HapeMask/rpi_experiments/resources/trig_none.png

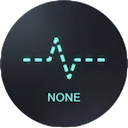
resources/trig_none.png
