HapeMask/rpi_experiments/resources/pressed_orig/trig_oneshot_pressed.png

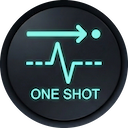
resources/pressed_orig/trig_oneshot_pressed.png
