HapeMask/rpi_experiments/resources/pan.png

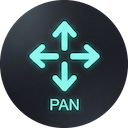
resources/pan.png
