HapeMask/rpi_experiments/resources/pan_pressed.png

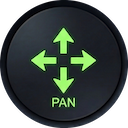
resources/pan_pressed.png
