HapeMask/rpi_experiments/resources/pause.png

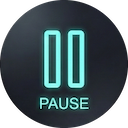
resources/pause.png
