HapeMask/rpi_experiments/resources/pause_pressed.png

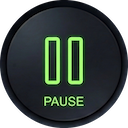
resources/pause_pressed.png
