HapeMask/rpi_experiments/resources/pressed_orig/pause_pressed.png

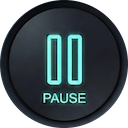
resources/pressed_orig/pause_pressed.png
