HapeMask/rpi_experiments/resources/pressed_orig/reset_zoom_pressed.png

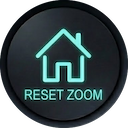
resources/pressed_orig/reset_zoom_pressed.png
