HapeMask/rpi_experiments/resources/pressed_orig/trig_auto_pressed.png

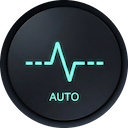
resources/pressed_orig/trig_auto_pressed.png
