HapeMask/rpi_experiments/resources/pressed_orig/trig_falling_pressed.png

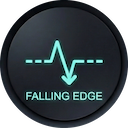
resources/pressed_orig/trig_falling_pressed.png
