HapeMask/rpi_experiments/resources/pressed_orig/trig_rising_pressed.png

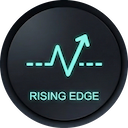
resources/pressed_orig/trig_rising_pressed.png
