HapeMask/rpi_experiments/resources/pressed_orig/zoom_pressed.png

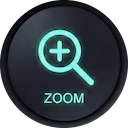
resources/pressed_orig/zoom_pressed.png
