HapeMask/rpi_experiments/resources/reset_zoom.png

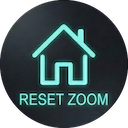
resources/reset_zoom.png
