HapeMask/rpi_experiments/resources/reset_zoom_pressed.png

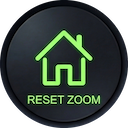
resources/reset_zoom_pressed.png
