HapeMask/rpi_experiments/resources/trig_falling.png

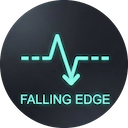
resources/trig_falling.png
