HapeMask/rpi_experiments/resources/trig_falling_pressed.png

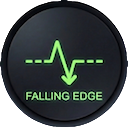
resources/trig_falling_pressed.png
