HapeMask/rpi_experiments/resources/trig_none_pressed.png

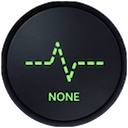
resources/trig_none_pressed.png
