HapeMask/rpi_experiments/resources/trig_oneshot.png

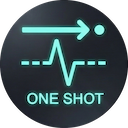
resources/trig_oneshot.png
