HapeMask/rpi_experiments/resources/trig_oneshot_pressed.png

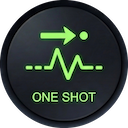
resources/trig_oneshot_pressed.png
