HapeMask/rpi_experiments/resources/trig_rising.png

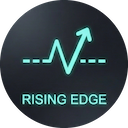
resources/trig_rising.png
