HapeMask/rpi_experiments/resources/trig_rising_pressed.png

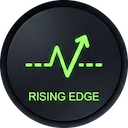
resources/trig_rising_pressed.png
