HapeMask/rpi_experiments/resources/zoom.png

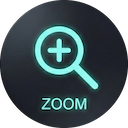
resources/zoom.png
