HapeMask/rpi_experiments/resources/zoom_pressed.png

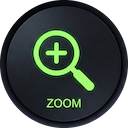
resources/zoom_pressed.png
