HapeMask/rpi_experiments/schematics/rpi_oscilloscope/2-Channel RPi Oscilloscope.kicad_pcb

## KiCad design schematics/rpi_oscilloscope/2-Channel RPi Oscilloscope.kicad_pcb (2026-06-03)

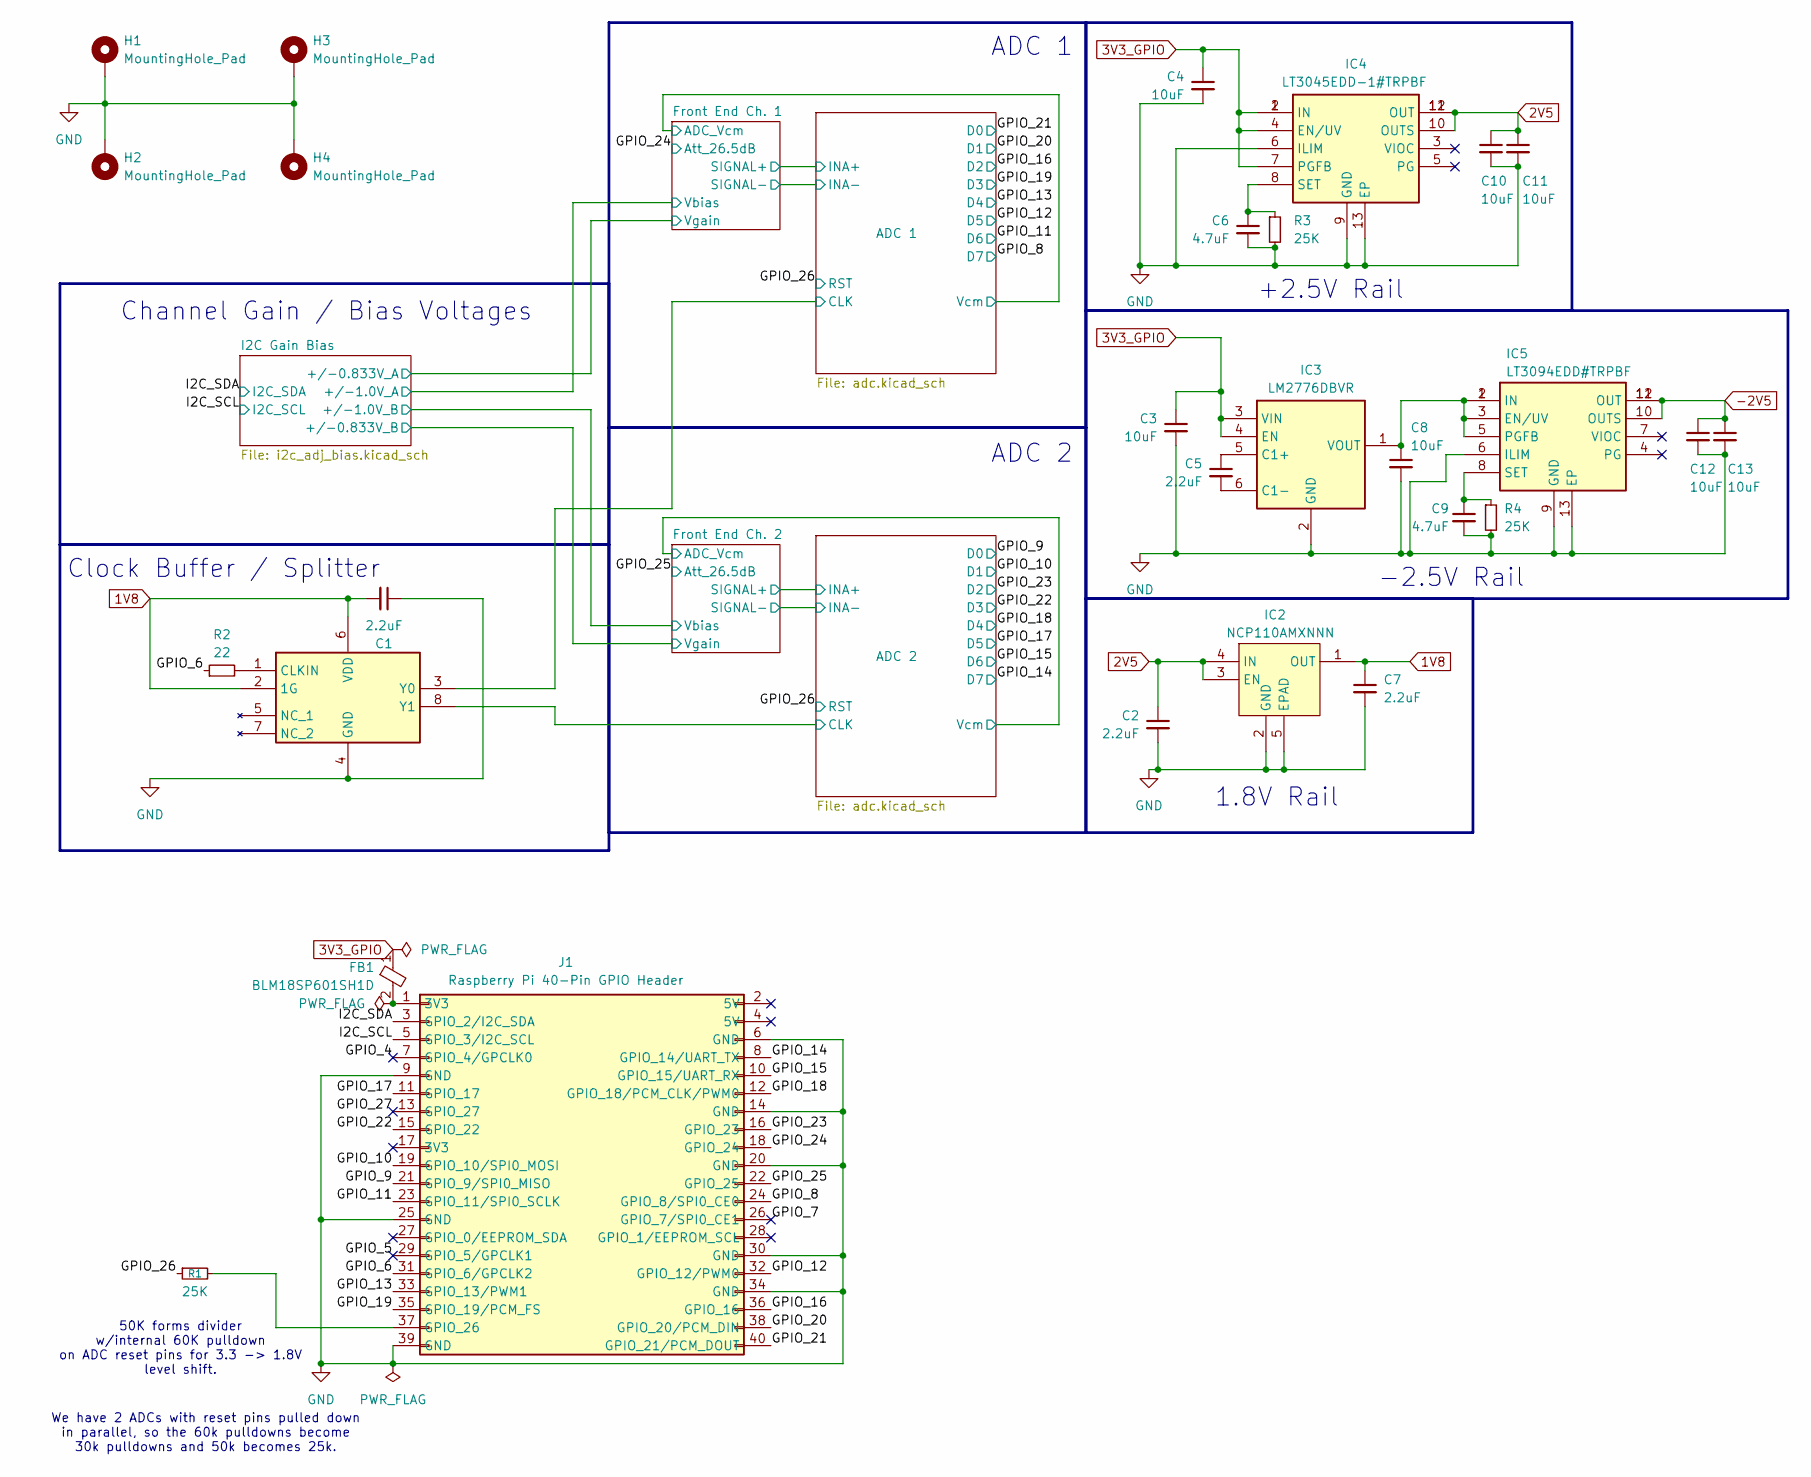
[picture p24: schematic 2-Channel RPi Oscilloscope.kicad_sch]

Parts:
C1, C2, C5, C7: 2.2uF; C_0805_2012Metric
C3, C4, C8, C10, C11, C12, C13: 10uF; C_0805_2012Metric; Manufacturer_Part_Number CL21B106KOQNNNE
C6, C9: 4.7uF; C_0805_2012Metric; Manufacturer_Part_Number GRM21BR71C475ME51K
FB1: BLM18SP601SH1D; BLM18SP221SN1B; Manufacturer_Part_Number BLM18SP601SH1D; Mouser Part Number 81-BLM18SP601SH1D
H1, H2, H3, H4: MountingHole_Pad; MountingHole_3mm_Pad_TopBottom
IC1: LMK1C1102PWR; SOP65P640X120-8N; Manufacturer_Part_Number LMK1C1102PWR; Mouser Part Number 595-LMK1C1102PWR
IC2: NCP110AMXNNN; OnSemi_XDFN4-1EP_1.0x1.0mm_EP0.52x0.52mm; Manufacturer_Part_Number NCP110AMX180TBG
IC3: LM2776DBVR; SOT95P280X145-6N; Manufacturer_Part_Number LM2776DBVR; Mouser Part Number 595-LM2776DBVR
IC4: LT3045EDD-1#TRPBF; SON45P300X300X80-13N-D; Manufacturer_Part_Number LT3045EDD-1#TRPBF; Mouser Part Number 584-LT3045EDD-1TRPBF
IC5: LT3094EDD#TRPBF; SON45P300X300X80-13N-D; Manufacturer_Part_Number LT3094EDD#TRPBF; Mouser Part Number 584-LT3094EDD#TRPBF
J1: Raspberry Pi 40-Pin GPIO Header; PinSocket_2x20_P2.54mm_Vertical
R1: 25K; R_0805_2012Metric
R2: 22; R_0805_2012Metric; Manufacturer_Part_Number RS73G2ATTD22R0B
R3, R4: 25K; R_0805_2012Metric; Manufacturer_Part_Number CPF-A-0805B25KE

Connections:
1V8: C1.2, C7.1, IC1.2 (1G), IC1.6 (VDD), IC2.1 (OUT); also elsewhere on the board
2V5: C2.1, C10.1, C11.1, IC2.3 (EN), IC2.4 (IN), IC4.10 (OUTS), IC4.11 (OUT), IC4.12 (OUT); also elsewhere on the board
3V3_GPIO: C3.1, C4.1, FB1.1, IC3.3 (VIN), IC3.4 (EN), IC4.1 (IN), IC4.2 (IN), IC4.4 (EN/UV), IC4.7 (PGFB); also elsewhere on the board
-2V5: C12.1, C13.1, IC5.10 (OUTS), IC5.11 (OUT), IC5.12 (OUT); also elsewhere on the board
/ADC 1/CLK: IC1.3 (Y0); also elsewhere on the board
/ADC 2/CLK: IC1.8 (Y1); also elsewhere on the board
/GPIO_4: J1.7 (GPIO_4/GPCLK0)
/GPIO_5: J1.29 (GPIO_5/GPCLK1)
/GPIO_6: J1.31 (GPIO_6/GPCLK2), R2.1
/GPIO_7: J1.26 (GPIO_7/SPI0_CE1)
/GPIO_8: J1.24 (GPIO_8/SPI0_CE0); also elsewhere on the board
/GPIO_9: J1.21 (GPIO_9/SPI0_MISO); also elsewhere on the board
/GPIO_10: J1.19 (GPIO_10/SPI0_MOSI); also elsewhere on the board
/GPIO_11: J1.23 (GPIO_11/SPI0_SCLK); also elsewhere on the board
/GPIO_12: J1.32 (GPIO_12/PWM0); also elsewhere on the board
/GPIO_13: J1.33 (GPIO_13/PWM1); also elsewhere on the board
/GPIO_14: J1.8 (GPIO_14/UART_TX); also elsewhere on the board
/GPIO_15: J1.10 (GPIO_15/UART_RX); also elsewhere on the board
/GPIO_16: J1.36 (GPIO_16); also elsewhere on the board
/GPIO_17: J1.11 (GPIO_17); also elsewhere on the board
/GPIO_18: J1.12 (GPIO_18/PCM_CLK/PWM0); also elsewhere on the board
/GPIO_19: J1.35 (GPIO_19/PCM_FS); also elsewhere on the board
/GPIO_20: J1.38 (GPIO_20/PCM_DIN); also elsewhere on the board
/GPIO_21: J1.40 (GPIO_21/PCM_DOUT); also elsewhere on the board
/GPIO_22: J1.15 (GPIO_22); also elsewhere on the board
/GPIO_23: J1.16 (GPIO_23); also elsewhere on the board
/GPIO_24: J1.18 (GPIO_24); also elsewhere on the board
/GPIO_25: J1.22 (GPIO_25); also elsewhere on the board
/GPIO_26: R1.1; also elsewhere on the board
/GPIO_27: J1.13 (GPIO_27)
/I2C_SCL: J1.5 (GPIO_3/I2C_SCL); also elsewhere on the board
/I2C_SDA: J1.3 (GPIO_2/I2C_SDA); also elsewhere on the board
GND: C1.1, C2.2, C3.2, C4.2, C6.2, C7.2, C8.2, C9.2, C10.2, C11.2, C12.2, C13.2, H1.1, H2.1, H3.1, H4.1, IC1.4 (GND), IC2.2 (GND), IC2.5 (EPAD), IC3.2 (GND), IC4.6 (ILIM), IC4.9 (GND), IC4.13 (EP), IC5.6 (ILIM), IC5.9 (GND), IC5.13 (EP), J1.6 (GND), J1.9 (GND), J1.14 (GND), J1.20 (GND), J1.25 (GND), J1.30 (GND), J1.34 (GND), J1.39 (GND), R3.2, R4.2; also elsewhere on the board
unnamed: FB1.2, J1.1 (3V3)
unnamed: IC1.1 (CLKIN), R2.2
unnamed: C5.1, IC3.5 (C1+)
unnamed: C5.2, IC3.6 (C1-)
unnamed: C8.1, IC3.1 (VOUT), IC5.1 (IN), IC5.2 (IN), IC5.3 (EN/UV), IC5.5 (PGFB)
unnamed: C6.1, IC4.8 (SET), R3.1
unnamed: C9.1, IC5.8 (SET), R4.1
unnamed: J1.37 (GPIO_26), R1.2

Notes on the sheet:
ADC 1
ADC 2
We have 2 ADCs with reset pins pulled down in parallel, so the 60k pulldowns become 30k pulldowns and 50k becomes 25k.
+2.5V Rail
-2.5V Rail
1.8V Rail
50K forms divider w/internal 60K pulldown on ADC reset pins for 3.3 -> 1.8V level shift.
Clock Buffer / Splitter
Channel Gain / Bias Voltages

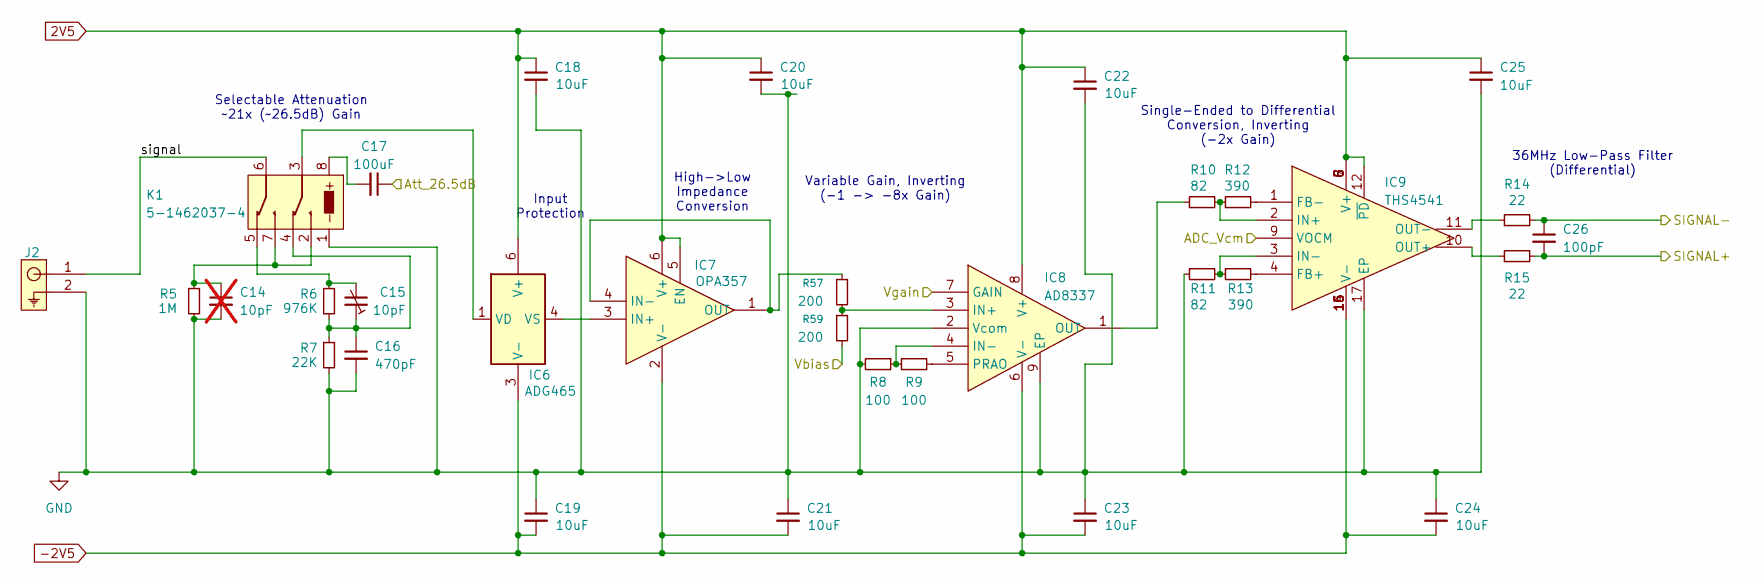
[picture p25: schematic frontend.kicad_sch]

Parts:
C14: 10pF; C_0805_2012Metric; not fitted
C15: 10pF; C_Trimmer_Sprague-Goodman_SGC3; Manufacturer_Part_Number SGC3S300
C16: 470pF; C_0805_2012Metric; Manufacturer_Part_Number GRM2165C1H201JA01D
C17: 100uF; C_1206_3216Metric; Manufacturer_Part_Number GRM31CR61A107MEA8L
C18, C19, C20, C21, C22, C23, C24, C25: 10uF; C_0805_2012Metric; Manufacturer_Part_Number CL21B106KOQNNNE
C26: 100pF; C_0805_2012Metric
IC6: ADG465; SOT95P280X145-6N; Manufacturer_Part_Number ADG465BRTZ-REEL7
IC7: OPA357; SOT95P280X145-6N; Manufacturer_Part_Number OPA357AIDBVR; Mouser Part Number 595-OPA357AIDBVR
IC8: AD8337; SON50P300X300X85-9N-D; Manufacturer_Part_Number AD8337BCPZ-REEL7; Mouser Part Number 584-AD8337BCPZ-R7
IC9: THS4541; QFN50P300X300X100-17N-D; Manufacturer_Part_Number THS4541IRGTR; Mouser Part Number 595-THS4541IRGTR
J2: 5-pin Coaxial Connector; 031_5431_10RFX; Manufacturer_Part_Number 031-5431-10RFX
K1: 5-1462037-4; 514620374; Manufacturer_Part_Number 5-1462037-4; Mouser Part Number 655-5-1462037-4
R5: 1M; R_0805_2012Metric
R6: 976K; R_0805_2012Metric
R7: 22K; R_0805_2012Metric
R8, R9: 100; R_0805_2012Metric
R10, R11: 82; R_0805_2012Metric
R12, R13: 390; R_0805_2012Metric
R14, R15: 22; R_0805_2012Metric; Manufacturer_Part_Number RS73G2ATTD22R0B
R57, R59: 200; R_0805_2012Metric

Connections:
2V5: C18.1, C20.1, C22.1, C25.1, IC6.6 (V+), IC7.5 (EN), IC7.6 (V+), IC8.8 (V+), IC9.5 (V+), IC9.6 (V+), IC9.7 (V+), IC9.8 (V+), IC9.12 (~PD); also elsewhere on the board
-2V5: C19.2, C21.2, C23.2, C24.2, IC6.3 (V-), IC7.2 (V-), IC8.6 (V-), IC9.13 (V-), IC9.14 (V-), IC9.15 (V-), IC9.16 (V-); also elsewhere on the board
/ADC 1/INA+: C26.2, R15.2; also elsewhere on the board
/ADC 1/INA-: C26.1, R14.2; also elsewhere on the board
/ADC 1/Vcm: IC9.9 (VOCM); also elsewhere on the board
/Front End Ch. 1/Vbias: R59.2; also elsewhere on the board
/Front End Ch. 1/Vgain: IC8.7 (GAIN); also elsewhere on the board
/Front End Ch. 1/signal: J2.1, K1.6
/GPIO_24: C17.1; also elsewhere on the board
GND: C14.2, C16.2, C18.2, C19.1, C20.2, C21.1, C22.2, C23.1, C24.1, C25.2, IC8.2 (Vcom), IC8.9 (EP), IC9.17 (EP), J2.2, K1.1, R5.2, R7.2, R8.2, R11.1; also elsewhere on the board
unnamed: C14.1, K1.2, K1.7, R5.1
unnamed: C15.1, C16.1, K1.4, R6.2, R7.1
unnamed: C15.2, K1.5, R6.1
unnamed: C17.2, K1.8
unnamed: IC6.1 (VD), K1.3
unnamed: IC6.4 (VS), IC7.3 (IN+)
unnamed: IC7.1 (OUT), IC7.4 (IN-), R57.1
unnamed: IC8.3 (IN+), R57.2, R59.1
unnamed: IC8.4 (IN-), R8.1, R9.1
unnamed: IC8.1 (OUT), R10.1
unnamed: IC8.5 (PRAO), R9.2
unnamed: IC9.4 (FB+), R13.2
unnamed: IC9.1 (FB-), R12.2
unnamed: IC9.2 (IN+), R10.2, R12.1
unnamed: IC9.3 (IN-), R11.2, R13.1
unnamed: IC9.10 (OUT+), R15.1
unnamed: IC9.11 (OUT-), R14.1

Parts of its further copies:
C27: 10pF; C_0805_2012Metric; not fitted
C28: 10pF; C_Trimmer_Sprague-Goodman_SGC3; Manufacturer_Part_Number SGC3S300
C29: 470pF; C_0805_2012Metric; Manufacturer_Part_Number GRM2165C1H201JA01D
C30: 100uF; C_1206_3216Metric; Manufacturer_Part_Number GRM31CR61A107MEA8L
C31, C32, C33, C34, C35, C36, C37, C38: 10uF; C_0805_2012Metric; Manufacturer_Part_Number CL21B106KOQNNNE
C39: 100pF; C_0805_2012Metric
IC10: ADG465; SOT95P280X145-6N; Manufacturer_Part_Number ADG465BRTZ-REEL7
IC11: OPA357; SOT95P280X145-6N; Manufacturer_Part_Number OPA357AIDBVR; Mouser Part Number 595-OPA357AIDBVR
IC12: AD8337; SON50P300X300X85-9N-D; Manufacturer_Part_Number AD8337BCPZ-REEL7; Mouser Part Number 584-AD8337BCPZ-R7
IC13: THS4541; QFN50P300X300X100-17N-D; Manufacturer_Part_Number THS4541IRGTR; Mouser Part Number 595-THS4541IRGTR
J3: 5-pin Coaxial Connector; 031_5431_10RFX; Manufacturer_Part_Number 031-5431-10RFX
K2: 5-1462037-4; 514620374; Manufacturer_Part_Number 5-1462037-4; Mouser Part Number 655-5-1462037-4
R16: 1M; R_0805_2012Metric
R17: 976K; R_0805_2012Metric
R18: 22K; R_0805_2012Metric
R19, R20: 100; R_0805_2012Metric
R21, R22: 82; R_0805_2012Metric
R23, R24: 390; R_0805_2012Metric
R25, R26: 22; R_0805_2012Metric; Manufacturer_Part_Number RS73G2ATTD22R0B
R58, R60: 200; R_0805_2012Metric

Connections of its further copies:
2V5: C31.1, C33.1, C35.1, C38.1, IC10.6 (V+), IC11.5 (EN), IC11.6 (V+), IC12.8 (V+), IC13.5 (V+), IC13.6 (V+), IC13.7 (V+), IC13.8 (V+), IC13.12 (~PD); also elsewhere on the board
-2V5: C32.2, C34.2, C36.2, C37.2, IC10.3 (V-), IC11.2 (V-), IC12.6 (V-), IC13.13 (V-), IC13.14 (V-), IC13.15 (V-), IC13.16 (V-); also elsewhere on the board
/ADC 2/INA+: C39.2, R26.2; also elsewhere on the board
/ADC 2/INA-: C39.1, R25.2; also elsewhere on the board
/ADC 2/Vcm: IC13.9 (VOCM); also elsewhere on the board
/Front End Ch. 2/Vbias: R60.2; also elsewhere on the board
/Front End Ch. 2/Vgain: IC12.7 (GAIN); also elsewhere on the board
/Front End Ch. 2/signal: J3.1, K2.6
/GPIO_25: C30.1; also elsewhere on the board
GND: C27.2, C29.2, C31.2, C32.1, C33.2, C34.1, C35.2, C36.1, C37.1, C38.2, IC12.2 (Vcom), IC12.9 (EP), IC13.17 (EP), J3.2, K2.1, R16.2, R18.2, R19.2, R22.1; also elsewhere on the board
unnamed: C27.1, K2.2, K2.7, R16.1
unnamed: C28.1, C29.1, K2.4, R17.2, R18.1
unnamed: C28.2, K2.5, R17.1
unnamed: C30.2, K2.8
unnamed: IC10.1 (VD), K2.3
unnamed: IC10.4 (VS), IC11.3 (IN+)
unnamed: IC11.1 (OUT), IC11.4 (IN-), R58.1
unnamed: IC12.3 (IN+), R58.2, R60.1
unnamed: IC12.4 (IN-), R19.1, R20.1
unnamed: IC12.1 (OUT), R21.1
unnamed: IC12.5 (PRAO), R20.2
unnamed: IC13.4 (FB+), R24.2
unnamed: IC13.1 (FB-), R23.2
unnamed: IC13.2 (IN+), R21.2, R23.1
unnamed: IC13.3 (IN-), R22.2, R24.1
unnamed: IC13.10 (OUT+), R26.1
unnamed: IC13.11 (OUT-), R25.1

Notes on the sheet:
Input Protection
Single-Ended to Differential Conversion, Inverting (-2x Gain)
High->Low Impedance Conversion
36MHz Low-Pass Filter (Differential)
Selectable Attenuation ~21x (~26.5dB) Gain
Variable Gain, Inverting (-1 -> -8x Gain)

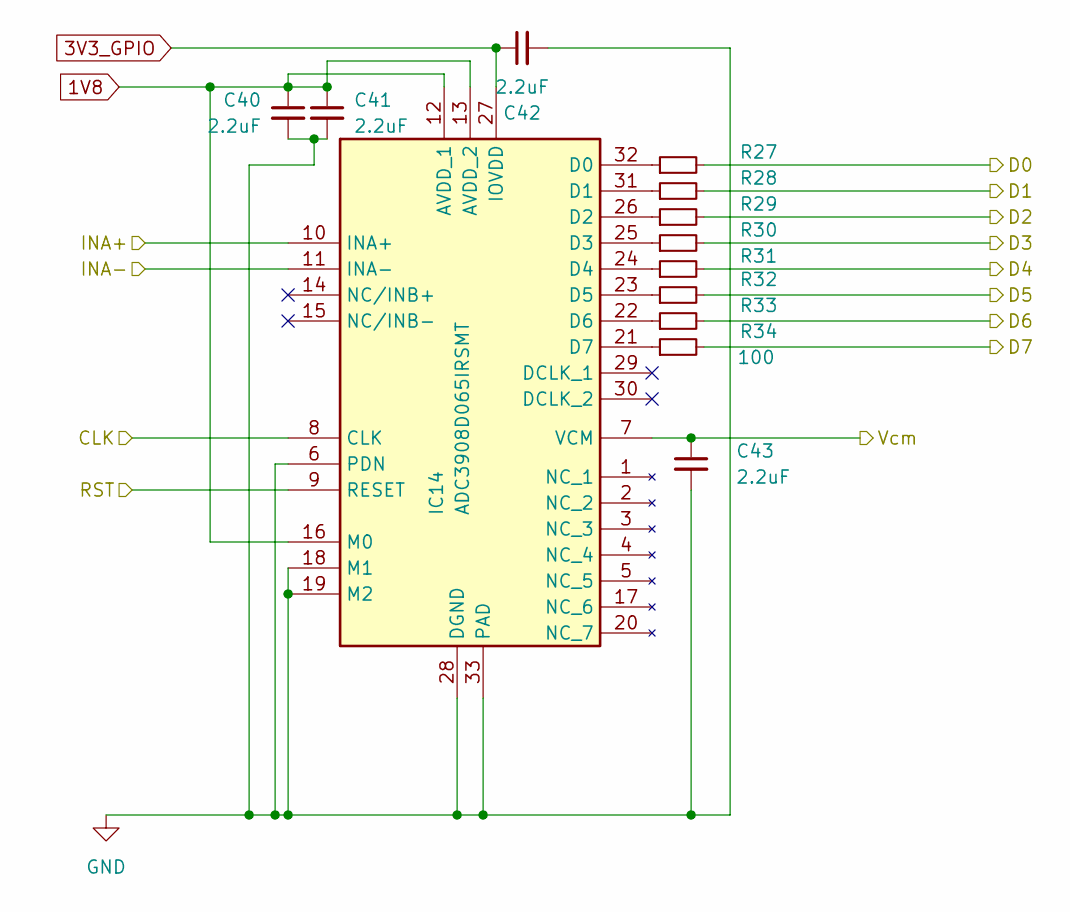
[picture p26: schematic adc.kicad_sch]

Parts:
C40, C41, C42, C43: 2.2uF; C_0805_2012Metric
IC14: ADC3908D065IRSMT; QFN40P400X400X100-33N-D; Manufacturer_Part_Number ADC3908D065IRSMT
R27, R28, R29, R30, R31, R32, R33, R34: 100; R_0805_2012Metric; Manufacturer_Part_Number RS73G2ATTD22R0B

Connections:
1V8: C40.1, C41.1, IC14.12 (AVDD_1), IC14.13 (AVDD_2), IC14.16 (M0); also elsewhere on the board
3V3_GPIO: C42.1, IC14.27 (IOVDD); also elsewhere on the board
/ADC 1/CLK: IC14.8 (CLK); also elsewhere on the board
/ADC 1/INA+: IC14.10 (INA+); also elsewhere on the board
/ADC 1/INA-: IC14.11 (INA-); also elsewhere on the board
/ADC 1/Vcm: C43.1, IC14.7 (VCM); also elsewhere on the board
/GPIO_8: R34.2; also elsewhere on the board
/GPIO_11: R33.2; also elsewhere on the board
/GPIO_12: R32.2; also elsewhere on the board
/GPIO_13: R31.2; also elsewhere on the board
/GPIO_16: R29.2; also elsewhere on the board
/GPIO_19: R30.2; also elsewhere on the board
/GPIO_20: R28.2; also elsewhere on the board
/GPIO_21: R27.2; also elsewhere on the board
/GPIO_26: IC14.9 (RESET); also elsewhere on the board
GND: C40.2, C41.2, C42.2, C43.2, IC14.6 (PDN), IC14.18 (M1), IC14.19 (M2), IC14.28 (DGND), IC14.33 (PAD); also elsewhere on the board
unnamed: IC14.32 (D0), R27.1
unnamed: IC14.31 (D1), R28.1
unnamed: IC14.26 (D2), R29.1
unnamed: IC14.25 (D3), R30.1
unnamed: IC14.24 (D4), R31.1
unnamed: IC14.23 (D5), R32.1
unnamed: IC14.22 (D6), R33.1
unnamed: IC14.21 (D7), R34.1

Parts of its further copies:
C44, C45, C46, C47: 2.2uF; C_0805_2012Metric
IC15: ADC3908D065IRSMT; QFN40P400X400X100-33N-D; Manufacturer_Part_Number ADC3908D065IRSMT
R35, R36, R37, R38, R39, R40, R41, R42: 100; R_0805_2012Metric; Manufacturer_Part_Number RS73G2ATTD22R0B

Connections of its further copies:
1V8: C44.1, C45.1, IC15.12 (AVDD_1), IC15.13 (AVDD_2), IC15.16 (M0); also elsewhere on the board
3V3_GPIO: C46.1, IC15.27 (IOVDD); also elsewhere on the board
/ADC 2/CLK: IC15.8 (CLK); also elsewhere on the board
/ADC 2/INA+: IC15.10 (INA+); also elsewhere on the board
/ADC 2/INA-: IC15.11 (INA-); also elsewhere on the board
/ADC 2/Vcm: C47.1, IC15.7 (VCM); also elsewhere on the board
/GPIO_9: R35.2; also elsewhere on the board
/GPIO_10: R36.2; also elsewhere on the board
/GPIO_14: R42.2; also elsewhere on the board
/GPIO_15: R41.2; also elsewhere on the board
/GPIO_17: R40.2; also elsewhere on the board
/GPIO_18: R39.2; also elsewhere on the board
/GPIO_22: R38.2; also elsewhere on the board
/GPIO_23: R37.2; also elsewhere on the board
/GPIO_26: IC15.9 (RESET); also elsewhere on the board
GND: C44.2, C45.2, C46.2, C47.2, IC15.6 (PDN), IC15.18 (M1), IC15.19 (M2), IC15.28 (DGND), IC15.33 (PAD); also elsewhere on the board
unnamed: IC15.32 (D0), R35.1
unnamed: IC15.31 (D1), R36.1
unnamed: IC15.26 (D2), R37.1
unnamed: IC15.25 (D3), R38.1
unnamed: IC15.24 (D4), R39.1
unnamed: IC15.23 (D5), R40.1
unnamed: IC15.22 (D6), R41.1
unnamed: IC15.21 (D7), R42.1

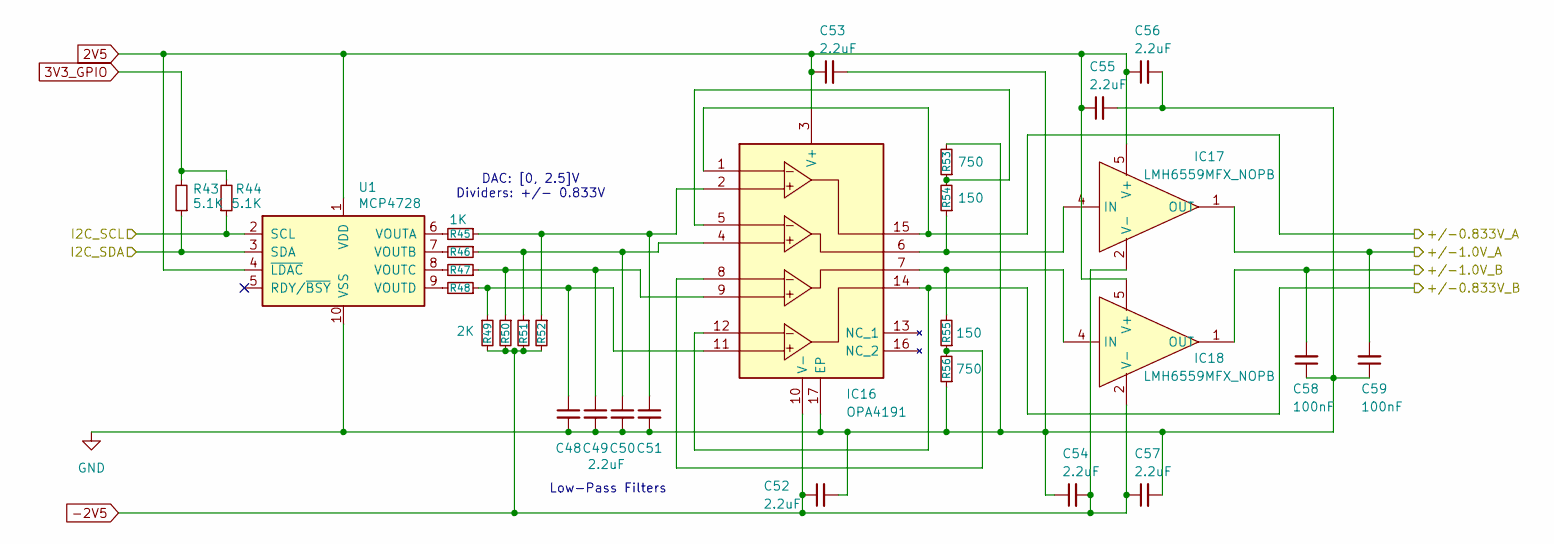
[picture p27: schematic i2c_adj_bias.kicad_sch]

Parts:
C48, C49, C50, C51, C52, C53, C54, C55, C56, C57: 2.2uF; C_0805_2012Metric
C58, C59: 100nF; C_0805_2012Metric
IC16: OPA4191; QFN65P400X400X80-17N-D; Manufacturer_Part_Number OPA4191IRUMR; Mouser Part Number 595-OPA4191IRUMR
IC17, IC18: LMH6559MFX_NOPB; SOT95P280X145-5N; Manufacturer_Part_Number LMH6559MFX/NOPB; Mouser Part Number 926-LMH6559MFX/NOPB
R43, R44: 5.1K; R_0805_2012Metric
R45, R46, R47, R48: 1K; R_0805_2012Metric
R49, R50, R51, R52: 2K; R_0805_2012Metric
R53, R56: 750; R_0805_2012Metric
R54, R55: 150; R_0805_2012Metric
U1: MCP4728; MSOP-10_3x3mm_P0.5mm; Manufacturer_Part_Number MCP4728T-E/UN

Connections:
2V5: C53.1, C55.1, C56.1, IC16.3 (V+), IC17.5 (V+), IC18.5 (V+), U1.1 (VDD), U1.4 (~LDAC); also elsewhere on the board
3V3_GPIO: R43.2, R44.2; also elsewhere on the board
-2V5: C52.1, C54.2, C57.1, IC16.10 (V-), IC17.2 (V-), IC18.2 (V-), R49.2, R50.2, R51.2, R52.2; also elsewhere on the board
/Front End Ch. 1/Vbias: C59.2, IC17.1 (OUT); also elsewhere on the board
/Front End Ch. 1/Vgain: IC16.1, IC16.15; also elsewhere on the board
/Front End Ch. 2/Vbias: C58.2, IC18.1 (OUT); also elsewhere on the board
/Front End Ch. 2/Vgain: IC16.12, IC16.14; also elsewhere on the board
/I2C_SCL: R44.1, U1.2 (SCL); also elsewhere on the board
/I2C_SDA: R43.1, U1.3 (SDA); also elsewhere on the board
GND: C48.2, C49.2, C50.2, C51.2, C52.2, C53.2, C54.1, C55.2, C56.2, C57.2, C58.1, C59.1, IC16.17 (EP), R53.2, R56.1, U1.10 (VSS); also elsewhere on the board
unnamed: C48.1, IC16.11, R48.1, R49.1
unnamed: C49.1, IC16.9, R47.1, R50.1
unnamed: C50.1, IC16.4, R46.1, R51.1
unnamed: C51.1, IC16.2, R45.1, R52.1
unnamed: IC16.5, R53.1, R54.2
unnamed: IC16.8, R55.1, R56.2
unnamed: IC16.6, IC17.4 (IN), R54.1
unnamed: IC16.7, IC18.4 (IN), R55.2
unnamed: R45.2, U1.6 (VOUTA)
unnamed: R46.2, U1.7 (VOUTB)
unnamed: R47.2, U1.8 (VOUTC)
unnamed: R48.2, U1.9 (VOUTD)

Notes on the sheet:
Low-Pass Filters
DAC: [0, 2.5]V Dividers: +/- 0.833V

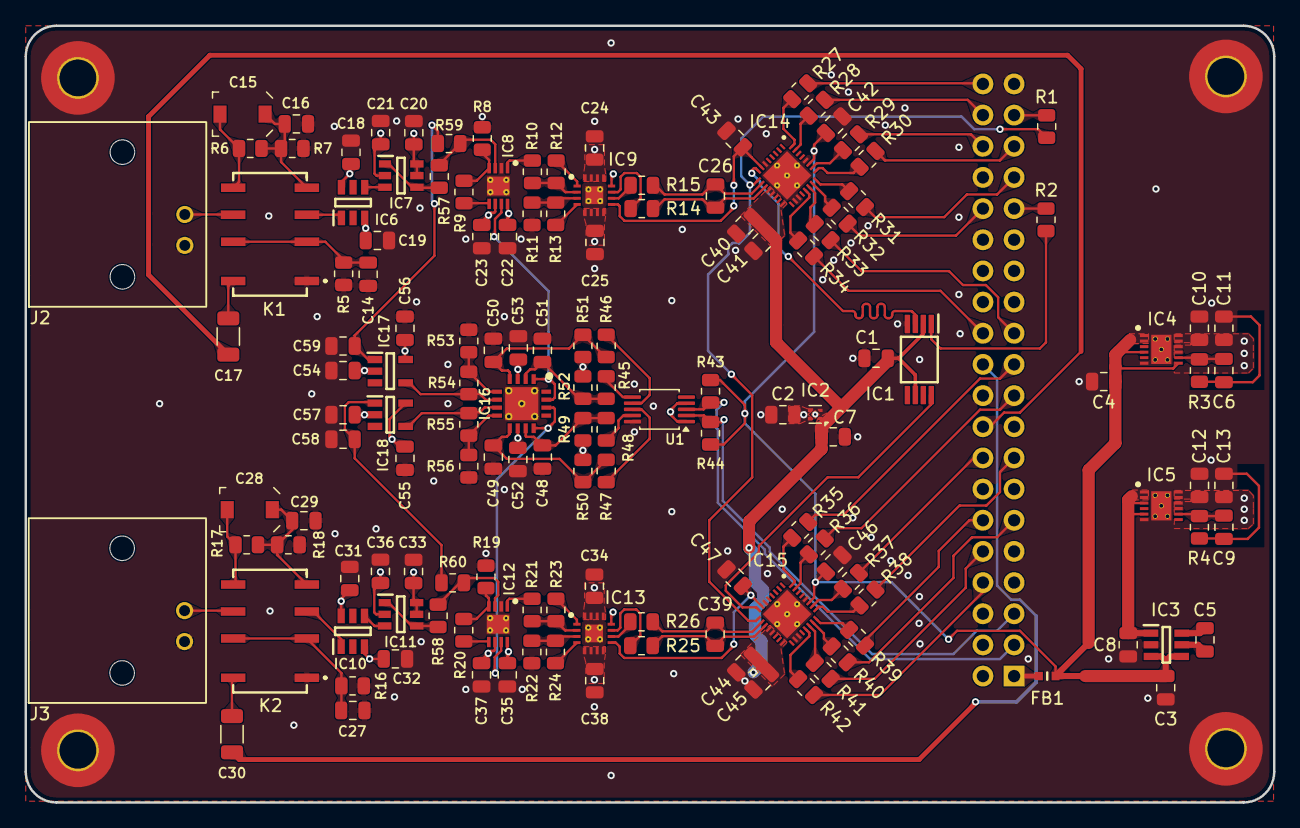
[picture p28: board 2-Channel RPi Oscilloscope.kicad_pcb from above]

Board: 4 copper layers, 101.8 x 63.3 mm, 148 parts (1 on the bottom side), 111 nets.
