HapeMask/rpi_experiments/src/freq_count.cpp

#include <chrono>
#include <cmath>
#include <iostream>
#include <string>
#include <thread>
#include <tuple>

#include <signal.h>

#include "frequency_counter.hpp"


static bool done = false;

void shutdown([[maybe_unused]] int signum) {
    done = true;
}

std::tuple<std::string, std::string, float> get_si_prefixes(float val) {
    std::string pref = "";
    std::string inv_pref = "";
    float scale = 1;

    if (val == 0) {
        return {pref, inv_pref, scale};
    }

    val = std::abs(val);
    auto lval = std::log10(val);
    bool flip = (val < 1);

    if (lval >= 12 || lval <= -9) {
        pref = "T";
        inv_pref = "p";
        scale = 1e12;
    } else if (lval >= 9 || lval <= -6) {
        pref = "G";
        inv_pref = "n";
        scale = 1e9;
    } else if (lval >= 6 || lval <= -3) {
        pref = "M";
        inv_pref = "u";
        scale = 1e6;
    } else if (lval >= 3 || lval < 0) {
        pref = "K";
        inv_pref = "m";
        scale = 1e3;
    }

    if (flip) {
        std::swap(pref, inv_pref);
        scale = 1.f / scale;
    }

    return {pref, inv_pref, scale};
}

int main(int argc, char** argv) {
    int tgt_sample_rate = 50'000'000;
    if (argc > 1) {
        tgt_sample_rate = std::stoi(argv[1]);
    }

    const auto [sr_pref, sr_inv_pref, sr_scale] = get_si_prefixes(tgt_sample_rate);
    std::cout << "Sample rate: " << (tgt_sample_rate / sr_scale) << " " << sr_pref << "Hz" << std::endl;

    FrequencyCounter fcount(tgt_sample_rate);

    signal(SIGINT, shutdown);
    while (!done) {
        const float freq = fcount.sample();
        const auto [pref, inv_pref, scale] = get_si_prefixes(freq);

        std::cout << "\rFreq: " << (freq / scale) << " " << pref << "Hz    " << std::flush;
        std::this_thread::sleep_for(std::chrono::seconds(1));
    }

    std::cout << std::endl;

    return 0;
}
