HapeMask/rpi_experiments/(commit log)

2025-12-02 Add many icons, fix triggering auto range, add pan/zoom toggles.
    [osc.py]
2025-12-02 [adc] Remove BufferedADC from python module, add interface for n_samples.
2025-12-02 [clock] More clock refactoring. Move PWM duty/freq into setup clocks and don't call it automatically.
2025-12-02 [adc] Rename old "DMA ADC" to SerialADC.
2025-12-02 [adc] Add new parallel ADC, support in python code, and multi-channel support.
2025-12-02 Replace VDD with more flexible VREF.
    [ads7884.cpp, osc.py, parallel_adc.cpp, parallel_adc.hpp, serial_adc.cpp, serial_adc.hpp, test.py]
2025-12-03 Switch VREF to support new circuit changes.
2025-12-12 Add ability to change the sample buffer size from inside the app.
2026-01-02 Switch to hard-coded list of acceptable sample rates.
2026-01-02 Switch to a numpy array for internal sample storage to avoid copies and other conversions.
    [osc.py, parallel_adc.cpp, parallel_adc.hpp]
2026-01-02 Fix bug that skipped the last sample when processing an odd number of samples.
    [parallel_adc.cpp]
2026-01-02 Fix issue resizing sample buffer after it has been returned at least once.
    [parallel_adc.cpp]
2026-01-02 Switch to PyQt6. Better support for dark mode and other things.
2026-01-02 Clean up sample rate / buffer size changing logic for channel toggling.
2026-01-09 Add basic interface for MCP4728 DAC via I2C.
2026-01-09 Switch threshold display toggle to push button for usability on touchscreens.
2026-01-09 Rename ads7884 module to represent current contents (more ADCs).
2026-03-11 Refactor ADC classes to move shared code into a base class.
2026-03-17 Expose 'real' SPI clock speed.
2026-03-17 Add CLI input for frequency counter sample rate.
2026-04-08 Add logic analyzer mode.
    This mode simply reads the GPIO level register as fast as possible
    w/DMA, and breaks the bits out into logic lines.
2026-04-08 Exposes logic analyzer mode and true multiple channel trace graphing to GUI.
2026-04-08 Logic analyzer mode uses chained DMA CBs with PWM gating to read at a fixed sample rate instead of whatever DMA can hit.
    [osc.py, parallel_adc.cpp, parallel_adc.hpp, serial_adc.cpp, serial_adc.hpp]
2026-04-08 Improve DMA wait behavior to adjust based on sample rate. Also add new very-slow sampling rates for LA mode in particular.
2026-04-08 Add threading support to C++ extension to stop blocking UI while the DMA transfers take place.
2026-04-08 Fix triggering offset caused by binning, also bug where updating wouldn't happen on startup.
    [adc.cpp, osc.py]
2026-04-08 Refactor LA mode into ADC base class
    Move DMA, GPIO, PWM, and AddressSpaceInfo peripherals from both subclasses
    into ADC. Implement all logic-analyzer fetch/setup/decode logic as base-class
    methods (_setup_la_dma_cbs, _start/_finish/_abort_la_fetch, _la_resize,
    _la_start_sampling, _la_alloc/free_buf). Move set_logic_analyzer_mode() to
    a non-virtual base implementation. Add _on_la_mode_exit() pure virtual so
    each subclass only needs to restore its own non-LA hardware state.
2026-04-08 Support larger sample buffers via chained DMA CBs
    ParallelADC: chain multiple DMA CBs (≤65534 bytes each) so SMI captures
    can exceed the 16-bit DMA len field limit, supporting up to 262144 samples.
    SerialADC: split captures that exceed 32767 samples across sequential SPI
    transactions managed by _advance_spi_segment(); each segment fits within
    the 16-bit SPI DL field.
    osc.py: extend AVAILABLE_BUFFER_SIZES to 262144, raise LA_MAX_SAMPLES to
    65535, and remove the forced 16384-sample cap on dual-channel mode.
2026-04-08 Make DMA wait failures only throw in debug builds.
    [adc.cpp, parallel_adc.cpp, serial_adc.cpp]
2026-04-08 Skip stale get_buffers calls via generation counter; cache timestamp array
    [adc.cpp, adc.hpp, adc_interfaces.cpp, osc.py]
2026-04-08 Fix cache-unfriendly loop order in _finish_la_fetch
    [adc.cpp]
2026-04-08 Replace trig_mode std::string with TrigMode enum to avoid per-frame allocation
    [adc.cpp, adc.hpp, adc_interfaces.cpp, osc.py]
2026-04-08 Make sure ADC stops when entering LA mode and restarts when exiting LA mode.
2026-04-13 Add real logic for ADC full scale ranges, gains, and biases. Move chip-specific logic into these new classes.
2026-04-13 Clean up sample buffer data structures. Improve binning to use screen X (time) range in addition to screen pixel width to determine samples per bin.
2026-04-13 Let user switch ADCs w/CLI flag.
2026-04-13 Add GPIO register push/pop mode mechanism and fix LA mode GPIO pins not being set to inputs.
    [adc.cpp, gpio.cpp, gpio.hpp]
2026-04-15 Add voltage range selection and associated DAC configuration.
2026-04-20 Make input FSR selectable per-channel, and correct trigger level (map it from real input range -> ADC FSR).
    [adc_interfaces.cpp, adcs.py, osc.py, parallel_adc.cpp, parallel_adc.hpp]
2026-04-20 Remove CSS and icons from buttons.
2026-04-20 Typing fixes and add pyproject.toml with mypy config.
    [adcs.py, custom_viewbox.py, osc.py]
2026-04-20 Remove active-channel-count-dependent availablity of sample rates.
2026-04-20 Fix missing elif clause in get_si_prefixes.
    [custom_viewbox.py, osc.py]
2026-04-21 Code cleanup. Split __init__ into more methods. Add colors to channel enable buttons.
2026-04-21 Add VGA calibration factor, fix bugs in FSR range calculations.
    [adcs.py, osc.py]
2026-04-21 Resurrect ADS7884 in the new framework.
2026-04-22 Don't reset graph when changing channel configs.
    [osc.py]
2026-06-03 Add 2ch. oscilloscope schematics.
    [2-Channel RPi Oscilloscope.kicad_pcb, 2-Channel RPi Oscilloscope.kicad_sch, adc.kicad_sch, frontend.kicad_sch, gain_bias_dac.kicad_sch, i2c_adj_bias copy.kicad_sch, i2c_adj_bias.kicad_sch]
